kmani314/device-one/README.md

# 明方電気 device one

device one

The **device one** is a 60% mechanical keyboard kit that  contains two PCBs, mounting hardware, 3D-printed feet, and anti-skid  inserts. The PCB has a USB-C connector and supports ANSI, ISO,  split-backspace, split-shift, and arrow key layouts. It is programmable  using the open-source QMK software.
