kmani314/device-one/backplate/plot/backplate-Back.png

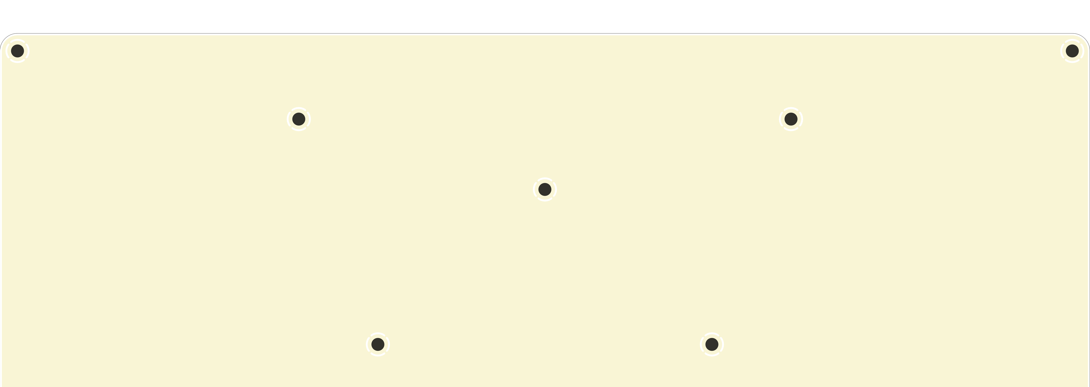
backplate/plot/backplate-Back.png
