kmani314/device-one/backplate/plot/backplate-Front.png

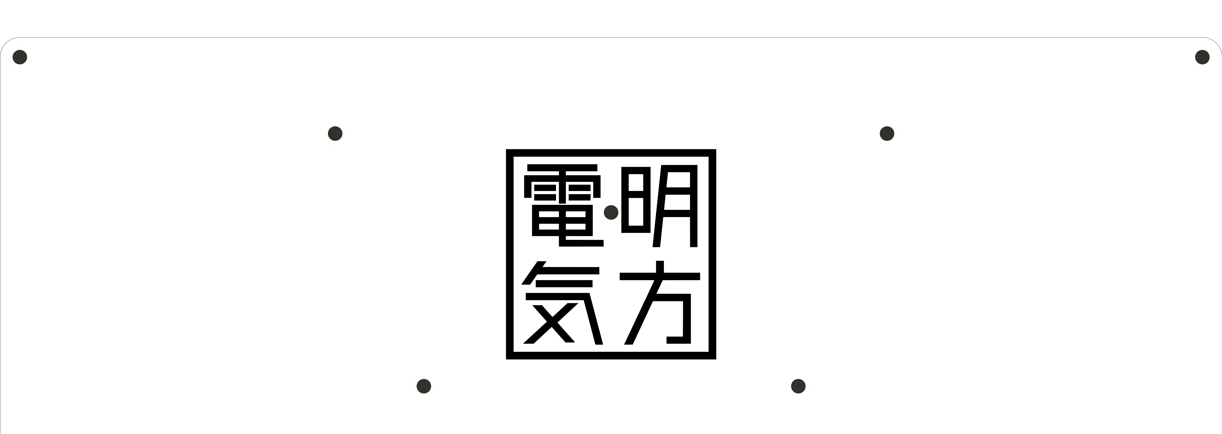
backplate/plot/backplate-Front.png
