kmani314/device-one/board/plot/61key-Back.png

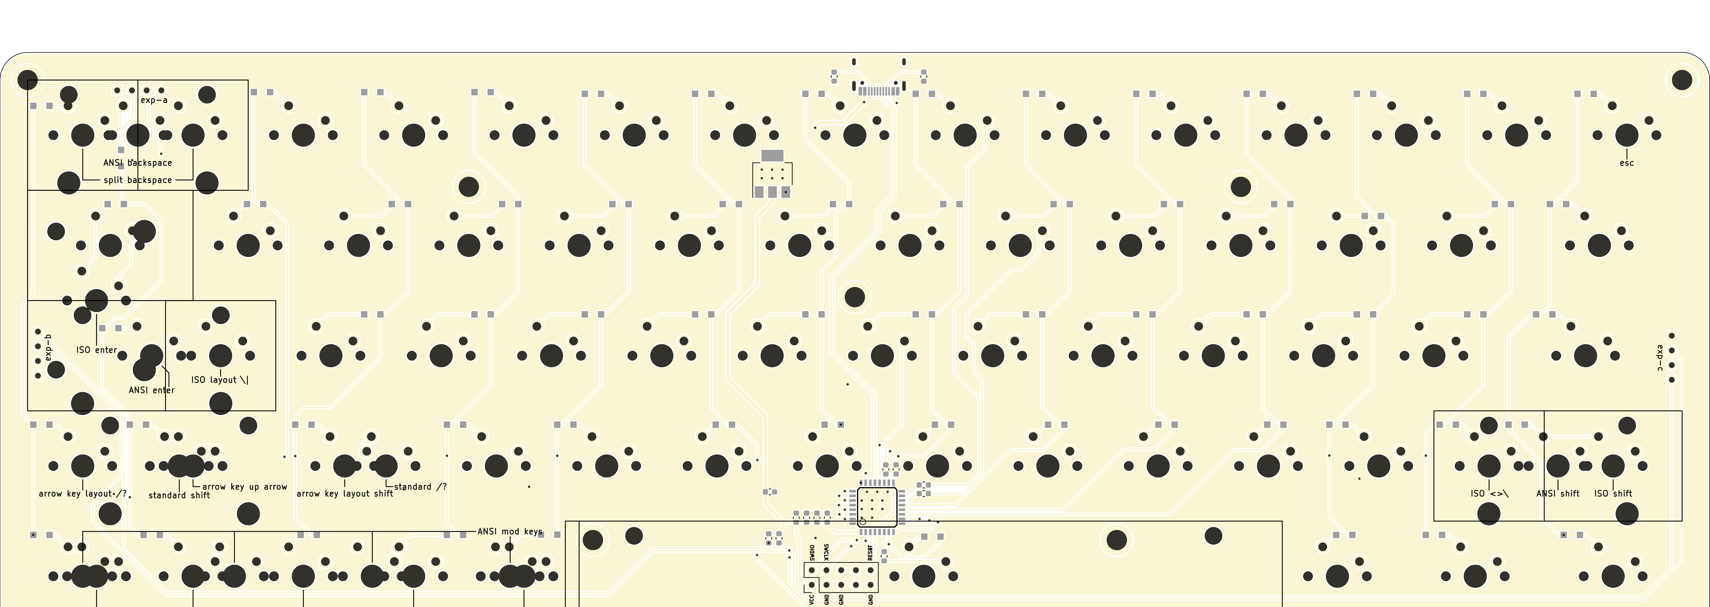
board/plot/61key-Back.png
