kmani314/device-one/board/plot/61key-Front.png

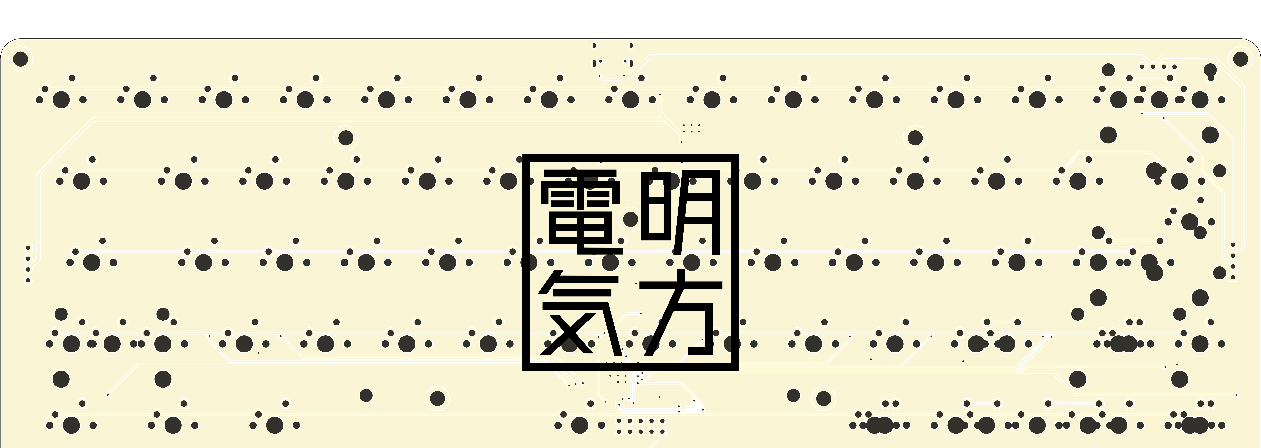
board/plot/61key-Front.png
