kmani314/device-one/backplate/backplate.step

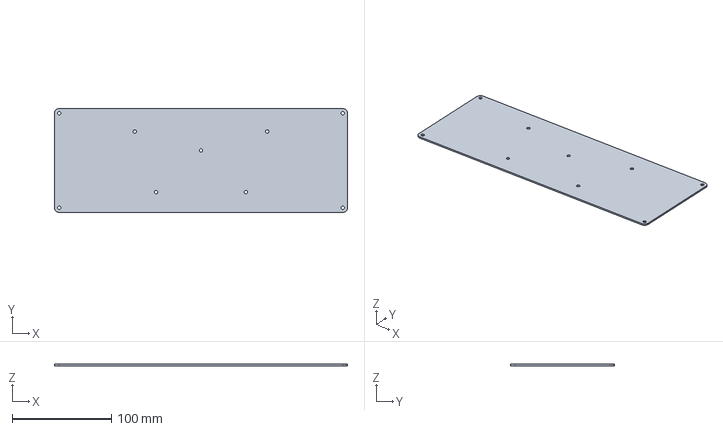
[picture p5: CAD file, 2020-05-29]
backplate/backplate.step
295.3 x 104.8 x 1.60 mm
