kmani314/device-one/board/61key.step

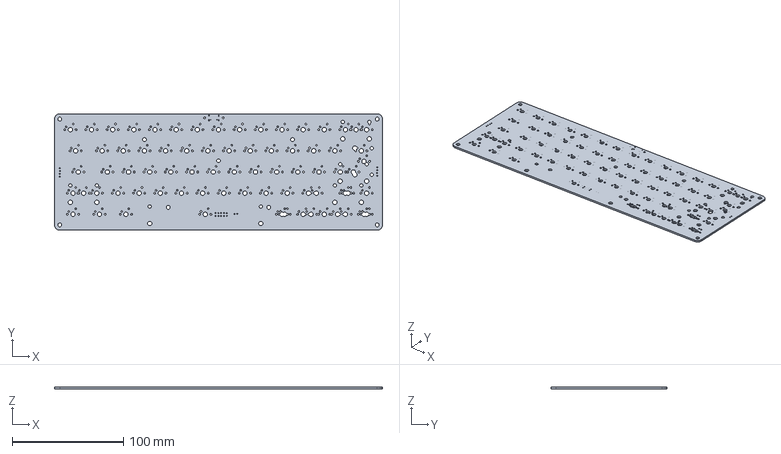
[picture p6: CAD file, 2020-06-21]
board/61key.step
295.3 x 104.8 x 1.60 mm
