kmani314/device-one/board/61key.kicad_pcb

## KiCad design board/61key.kicad_pcb (2020-07-10)

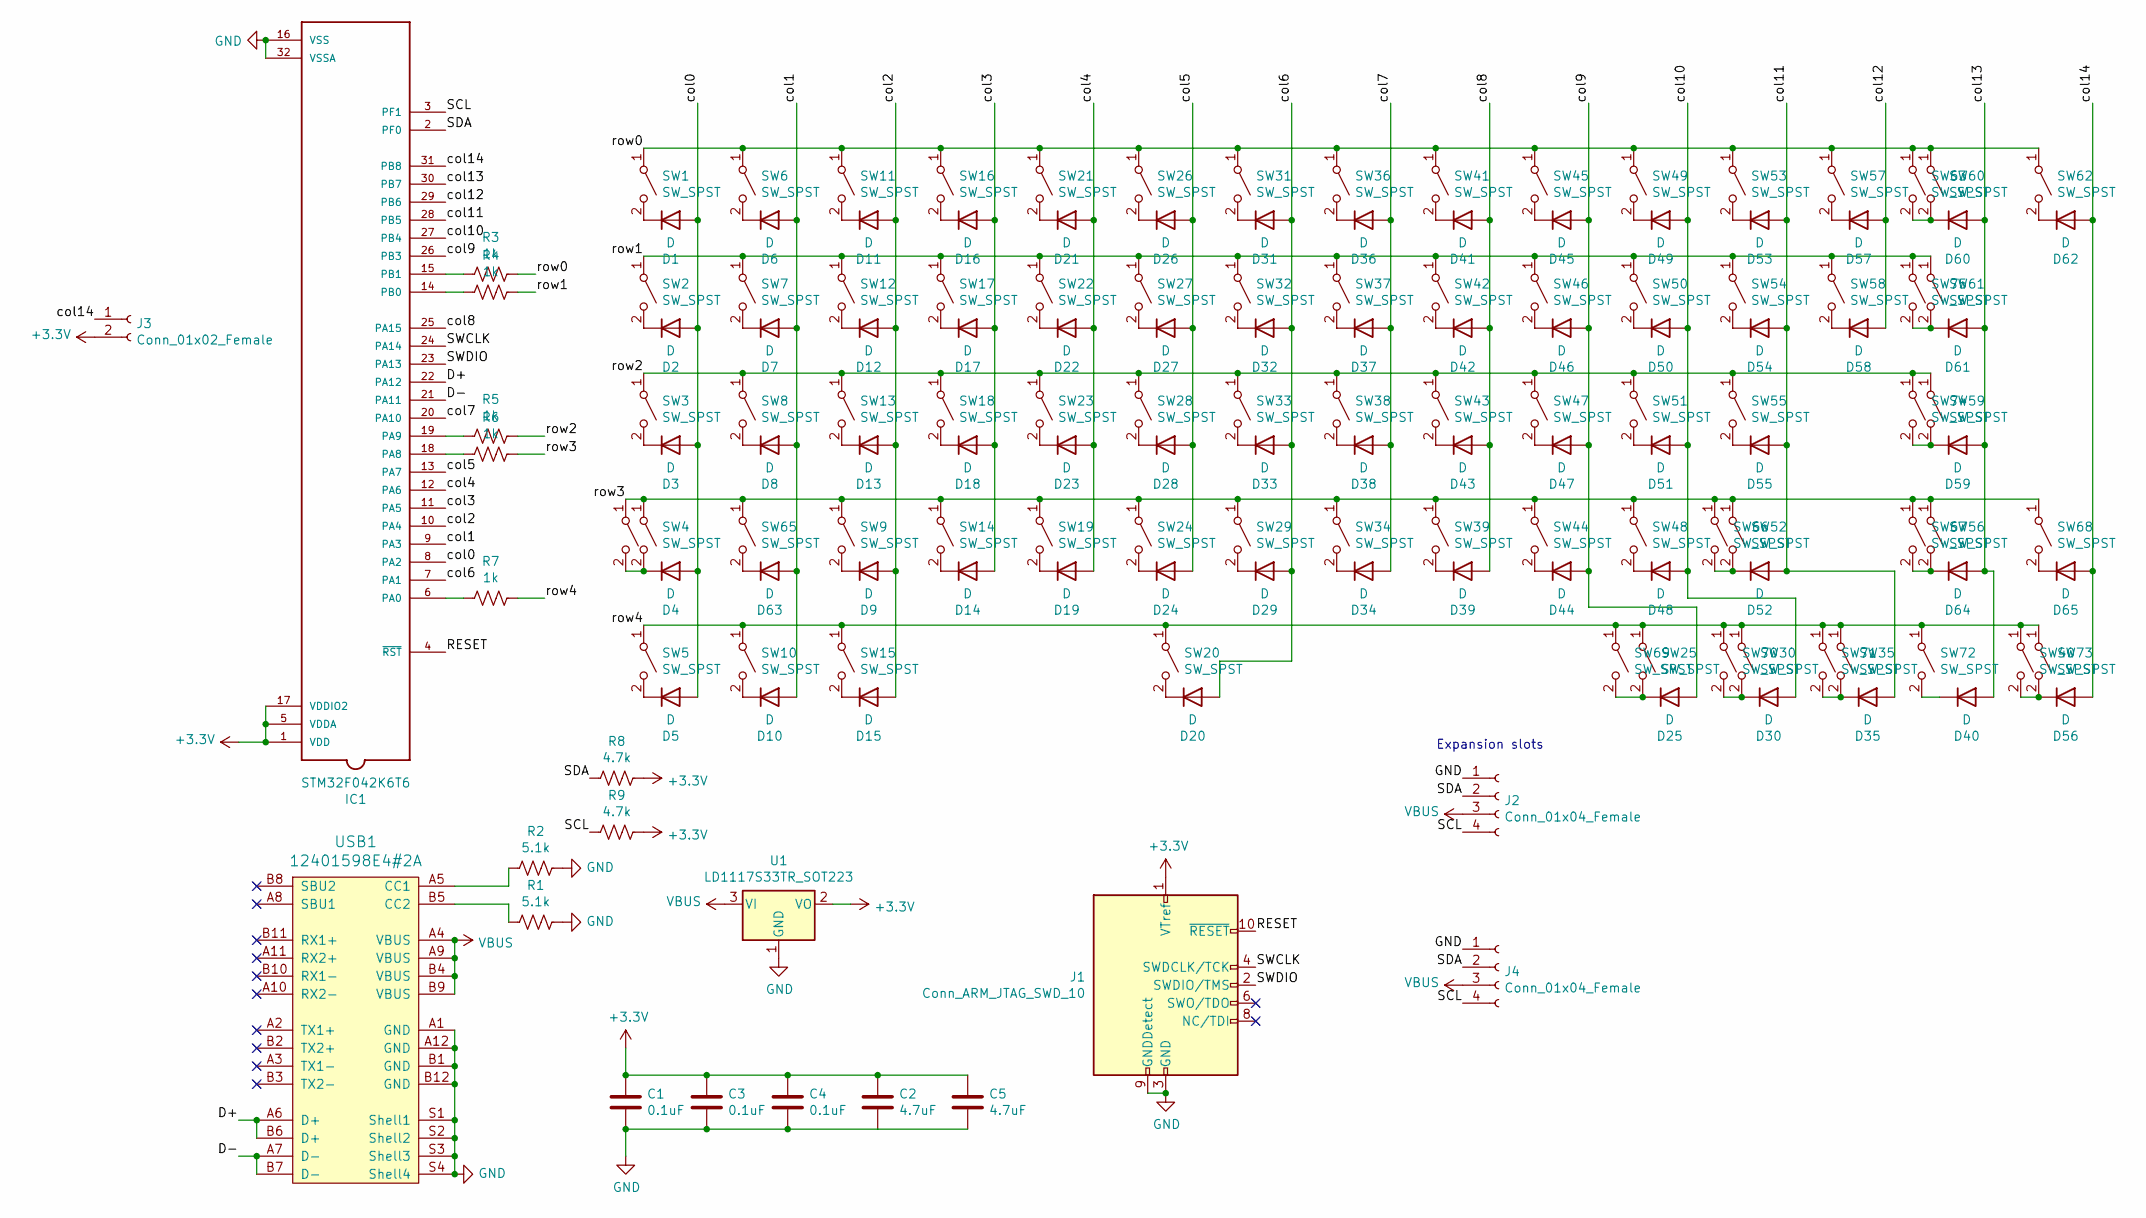
[picture p7: schematic 61key.sch]

Parts:
C1, C3, C4: 0.1uF; C_0603_1608Metric
C2, C5: 4.7uF; C_0603_1608Metric
D1, D2, D3, D4, D5, D6, D7, D8, D9, D10, D11, D12, D13, D14, D15, D16, D17, D18, D19, D20, D21, D22, D23, D24, D25, D26, D27, D28, D29, D30, D31, D32, D33, D34, D35, D36, D37, D38, D39, D40, D41, D42, D43, D44, D45, D46, D47, D48, D49, D50, D51, D52, D53, D54, D55, D56, D57, D58, D59, D60, D61, D62, D63, D64, D65: D; D_SOD-123F
IC1: STM32F042K6T6; QFP80P900X900X160-32N
J1: Conn_ARM_JTAG_SWD_10; PinHeader_2x05_P2.54mm_Vertical
J2, J4: Conn_01x04_Female; exp_header
J3: Conn_01x02_Female; PinHeader_1x02_P2.54mm_Vertical
R1, R2: 5.1k; R_0603_1608Metric
R3, R4, R5, R6, R7: 1k; R_0603_1608Metric
R8, R9: 4.7k; R_0603_1608Metric
SW1, SW2, SW3, SW4, SW5, SW6, SW7, SW8, SW9, SW10, SW11, SW12, SW13, SW14, SW15, SW16, SW17, SW18, SW19, SW20, SW21, SW22, SW23, SW24, SW25, SW26, SW27, SW28, SW29, SW30, SW31, SW32, SW33, SW34, SW35, SW36, SW37, SW38, SW39, SW40, SW41, SW42, SW43, SW44, SW45, SW46, SW47, SW48, SW49, SW50, SW51, SW52, SW53, SW54, SW55, SW56, SW57, SW58, SW59, SW60, SW61, SW62, SW63, SW64, SW65, SW66, SW67, SW68, SW69, SW70, SW71, SW72, SW73, SW74, SW75: SW_SPST; SW_MX
U1: LD1117S33TR_SOT223; SOT-223-3_TabPin2
USB1: 12401598E4#2A; HRO-TYPE-C-31-M-12

Connections:
+3V3: C1.1, C2.1, C3.1, C4.1, C5.1, IC1.1 (VDD), IC1.5 (VDDA), IC1.17 (VDDIO2), J1.1 (VTref), J3.2, R8.1, R9.1, U1.2 (VO)
/D+: IC1.22 (PA12), USB1.A6 (D+), USB1.B6 (D+)
/D-: IC1.21 (PA11), USB1.A7 (D-), USB1.B7 (D-)
/RESET: IC1.4 (~RST~), J1.10 (~RESET~)
/SCL: IC1.3 (PF1), J2.4, J4.4, R9.2
/SDA: IC1.2 (PF0), J2.2, J4.2, R8.2
/SWCLK: IC1.24 (PA14), J1.4 (SWDCLK/TCK)
/SWDIO: IC1.23 (PA13), J1.2 (SWDIO/TMS)
/col0: D1.2 (A), D2.2 (A), D3.2 (A), D4.2 (A), D5.2 (A), IC1.8 (PA2)
/col1: D6.2 (A), D7.2 (A), D8.2 (A), D10.2 (A), D63.2 (A), IC1.9 (PA3)
/col2: D9.2 (A), D11.2 (A), D12.2 (A), D13.2 (A), D15.2 (A), IC1.10 (PA4)
/col3: D14.2 (A), D16.2 (A), D17.2 (A), D18.2 (A), IC1.11 (PA5)
/col4: D19.2 (A), D21.2 (A), D22.2 (A), D23.2 (A), IC1.12 (PA6)
/col5: D24.2 (A), D26.2 (A), D27.2 (A), D28.2 (A), IC1.13 (PA7)
/col6: D20.2 (A), D29.2 (A), D31.2 (A), D32.2 (A), D33.2 (A), IC1.7 (PA1)
/col7: D34.2 (A), D36.2 (A), D37.2 (A), D38.2 (A), IC1.20 (PA10)
/col8: D39.2 (A), D41.2 (A), D42.2 (A), D43.2 (A), IC1.25 (PA15)
/col9: D25.2 (A), D44.2 (A), D45.2 (A), D46.2 (A), D47.2 (A), IC1.26 (PB3)
/col10: D30.2 (A), D48.2 (A), D49.2 (A), D50.2 (A), D51.2 (A), IC1.27 (PB4)
/col11: D35.2 (A), D52.2 (A), D53.2 (A), D54.2 (A), D55.2 (A), IC1.28 (PB5)
/col12: D57.2 (A), D58.2 (A), IC1.29 (PB6)
/col13: D40.2 (A), D59.2 (A), D60.2 (A), D61.2 (A), D64.2 (A), IC1.30 (PB7)
/col14: D56.2 (A), D62.2 (A), D65.2 (A), IC1.31 (PB8), J3.1
/row0: R3.1, SW1.1 (A), SW6.1 (A), SW11.1 (A), SW16.1 (A), SW21.1 (A), SW26.1 (A), SW31.1 (A), SW36.1 (A), SW41.1 (A), SW45.1 (A), SW49.1 (A), SW53.1 (A), SW57.1 (A), SW60.1 (A), SW62.1 (A), SW63.1 (A)
/row1: R4.1, SW2.1 (A), SW7.1 (A), SW12.1 (A), SW17.1 (A), SW22.1 (A), SW27.1 (A), SW32.1 (A), SW37.1 (A), SW42.1 (A), SW46.1 (A), SW50.1 (A), SW54.1 (A), SW58.1 (A), SW61.1 (A), SW75.1 (A)
/row2: R5.1, SW3.1 (A), SW8.1 (A), SW13.1 (A), SW18.1 (A), SW23.1 (A), SW28.1 (A), SW33.1 (A), SW38.1 (A), SW43.1 (A), SW47.1 (A), SW51.1 (A), SW55.1 (A), SW59.1 (A), SW74.1 (A)
/row3: R6.1, SW4.1 (A), SW9.1 (A), SW14.1 (A), SW19.1 (A), SW24.1 (A), SW29.1 (A), SW34.1 (A), SW39.1 (A), SW44.1 (A), SW48.1 (A), SW52.1 (A), SW56.1 (A), SW64.1 (A), SW65.1 (A), SW66.1 (A), SW67.1 (A), SW68.1 (A)
/row4: R7.1, SW5.1 (A), SW10.1 (A), SW15.1 (A), SW20.1 (A), SW25.1 (A), SW30.1 (A), SW35.1 (A), SW40.1 (A), SW69.1 (A), SW70.1 (A), SW71.1 (A), SW72.1 (A), SW73.1 (A)
GND: C1.2, C2.2, C3.2, C4.2, C5.2, IC1.16 (VSS), IC1.32 (VSSA), J1.3 (GND), J1.5 (GND), J1.9 (GNDDetect), J2.1, J4.1, R1.1, R2.1, U1.1 (GND), USB1.A1 (GND), USB1.A12 (GND), USB1.B1 (GND), USB1.B12 (GND), USB1.S1 (Shell1), USB1.S2 (Shell2), USB1.S3 (Shell3), USB1.S4 (Shell4)
unnamed: D1.1 (K), SW1.2 (B)
unnamed: D2.1 (K), SW2.2 (B)
unnamed: D3.1 (K), SW3.2 (B)
unnamed: D4.1 (K), SW4.2 (B), SW64.2 (B)
unnamed: D5.1 (K), SW5.2 (B)
unnamed: D6.1 (K), SW6.2 (B)
unnamed: D7.1 (K), SW7.2 (B)
unnamed: D8.1 (K), SW8.2 (B)
unnamed: D9.1 (K), SW9.2 (B)
unnamed: D10.1 (K), SW10.2 (B)
unnamed: D11.1 (K), SW11.2 (B)
unnamed: D12.1 (K), SW12.2 (B)
unnamed: D13.1 (K), SW13.2 (B)
unnamed: D14.1 (K), SW14.2 (B)
unnamed: D15.1 (K), SW15.2 (B)
unnamed: D16.1 (K), SW16.2 (B)
unnamed: D17.1 (K), SW17.2 (B)
unnamed: D18.1 (K), SW18.2 (B)
unnamed: D19.1 (K), SW19.2 (B)
unnamed: D20.1 (K), SW20.2 (B)
unnamed: D21.1 (K), SW21.2 (B)
unnamed: D22.1 (K), SW22.2 (B)
unnamed: D23.1 (K), SW23.2 (B)
unnamed: D24.1 (K), SW24.2 (B)
unnamed: D25.1 (K), SW25.2 (B), SW69.2 (B)
unnamed: D26.1 (K), SW26.2 (B)
unnamed: D27.1 (K), SW27.2 (B)
unnamed: D28.1 (K), SW28.2 (B)
unnamed: D29.1 (K), SW29.2 (B)
unnamed: D30.1 (K), SW30.2 (B), SW70.2 (B)
unnamed: D31.1 (K), SW31.2 (B)
unnamed: D32.1 (K), SW32.2 (B)
unnamed: D33.1 (K), SW33.2 (B)
unnamed: D34.1 (K), SW34.2 (B)
unnamed: D35.1 (K), SW35.2 (B), SW71.2 (B)
unnamed: D36.1 (K), SW36.2 (B)
unnamed: D37.1 (K), SW37.2 (B)
unnamed: D38.1 (K), SW38.2 (B)
unnamed: D39.1 (K), SW39.2 (B)
unnamed: D40.1 (K), SW72.2 (B)
unnamed: D41.1 (K), SW41.2 (B)
unnamed: D42.1 (K), SW42.2 (B)
unnamed: D43.1 (K), SW43.2 (B)
unnamed: D44.1 (K), SW44.2 (B)
unnamed: D45.1 (K), SW45.2 (B)
unnamed: D46.1 (K), SW46.2 (B)
unnamed: D47.1 (K), SW47.2 (B)
unnamed: D48.1 (K), SW48.2 (B)
unnamed: D49.1 (K), SW49.2 (B)
unnamed: D50.1 (K), SW50.2 (B)
unnamed: D51.1 (K), SW51.2 (B)
unnamed: D52.1 (K), SW52.2 (B), SW66.2 (B)
unnamed: D53.1 (K), SW53.2 (B)
unnamed: D54.1 (K), SW54.2 (B)
unnamed: D55.1 (K), SW55.2 (B)
unnamed: D56.1 (K), SW40.2 (B), SW73.2 (B)
unnamed: D57.1 (K), SW57.2 (B)
unnamed: D58.1 (K), SW58.2 (B)
unnamed: D59.1 (K), SW59.2 (B), SW74.2 (B)
unnamed: D60.1 (K), SW60.2 (B), SW63.2 (B)
unnamed: D61.1 (K), SW61.2 (B), SW75.2 (B)
unnamed: D62.1 (K), SW62.2 (B)
unnamed: D63.1 (K), SW65.2 (B)
unnamed: D64.1 (K), SW56.2 (B), SW67.2 (B)
unnamed: D65.1 (K), SW68.2 (B)
unnamed: IC1.6 (PA0), R7.2
unnamed: IC1.14 (PB0), R4.2
unnamed: IC1.15 (PB1), R3.2
unnamed: IC1.18 (PA8), R6.2
unnamed: IC1.19 (PA9), R5.2
unnamed: R1.2, USB1.B5 (CC2)
unnamed: R2.2, USB1.A5 (CC1)
VBUS: J2.3, J4.3, U1.3 (VI), USB1.A4 (VBUS), USB1.A9 (VBUS), USB1.B4 (VBUS), USB1.B9 (VBUS)

Notes on the sheet:
Expansion slots

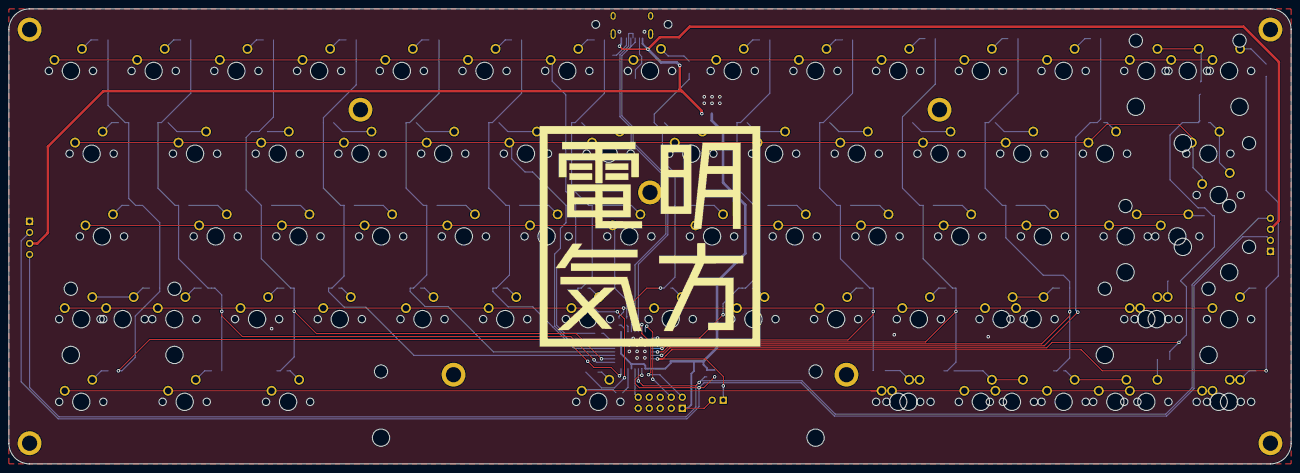
[picture p8: board 61key.kicad_pcb from above]

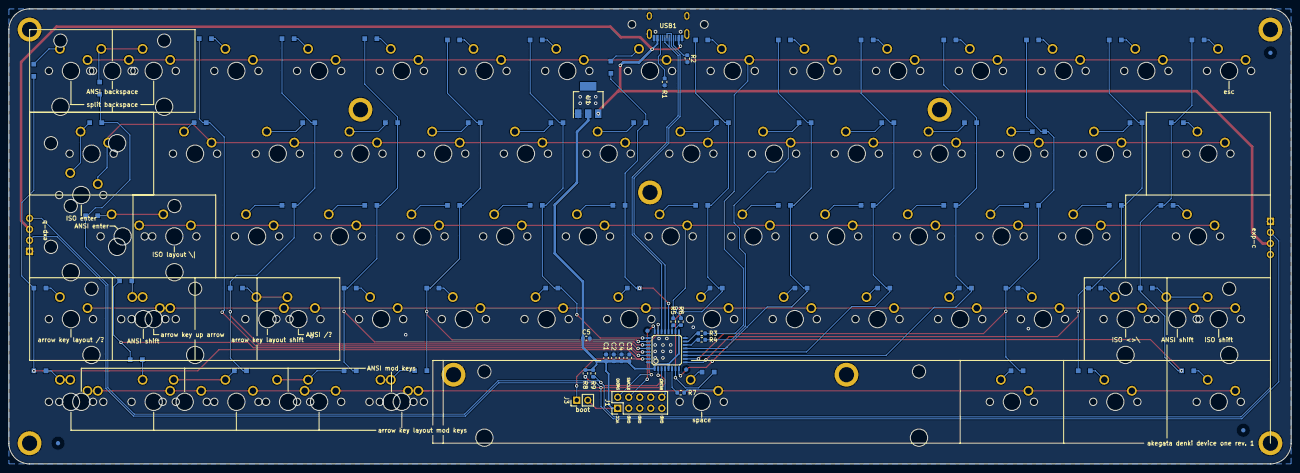
[picture p9: board 61key.kicad_pcb from below]

Board: 2 copper layers, 295.3 x 104.8 mm, 172 parts (89 on the bottom side), 102 nets.

Other parts of the board:
>NAME: >VALUE; MX_STAB_6.75U
>NAME#2: >VALUE; MX_STAB_2.75U
>NAME#3, >NAME#4: >VALUE; MX_STAB_2.25U
F1, F4, F5: Fiducial_1mm_Mask3mm
F2, F3: Fiducial_1mm_Mask2mm
ST72, ST72#2: Stabilizer; MX_STAB_2U
