kmani314/device-one/(commit log)

2020-05-03 add footprints, finish basic schematic, working on pcb
    [61key.kicad_pcb, 61key.sch, Keyboard.sch]
2020-05-04 footprints, key arrangement, board dimensions
    [61key.kicad_pcb, 61key.sch]
2020-05-05 basic pcb, issues with holes
    [61key.kicad_pcb, 61key.sch]
2020-05-06 add step for renders
    [61key.step]
2020-05-06 optimize entire board
    [61key.kicad_pcb, 61key.sch]
2020-05-07 clean up files, move things to their own directories
    [61key.kicad_pcb, 61key.sch, 61key.step, Keyboard.sch]
2020-05-07 add pads, new step
    [61key.kicad_pcb, 61key.sch, 61key.step]
2020-05-07 add board images, remove svg
    [61key.sch]
2020-05-07 add better img and logo
    [61key.kicad_pcb]
2020-05-09 new images, backplate, clean up for smt assembly
    [61key.kicad_pcb, 61key.sch, backplate.kicad_pcb, backplate.sch]
2020-05-13 big overhaul
    [61key.kicad_pcb, 61key.sch, 61key.step]
2020-05-14 layouts done, need to add traces
    [61key.kicad_pcb, 61key.sch, 61key.step]
2020-05-15 rows and columns for all layouts done
    [61key.kicad_pcb, 61key.sch]
2020-05-16 basic pcb done
    [61key.kicad_pcb, 61key.sch]
2020-05-17 need to create models to check board compatibility; prototype candidate
    [61key.kicad_pcb, 61key.sch, 61key.step, backplate.kicad_pcb, backplate.sch, backplate.step]
2020-05-17 logos, gerber
    [61key.kicad_pcb, 61key.step, backplate.kicad_pcb, backplate.step]
2020-05-17 backplate fixes
    [61key.kicad_pcb, backplate.kicad_pcb]
2020-05-26 add dxf
    [61key-B_Fab.dxf, 61key-B_Mask.dxf, 61key-B_SilkS.dxf, 61key-Edge_Cuts.dxf, 61key-F_Cu.dxf, 61key-F_Fab.dxf, 61key-F_Mask.dxf, 61key-F_SilkS.dxf]
2020-05-29 new images and steps
    [61key.step, backplate.step]
2020-06-21 update step file
    [61key.step]
2020-07-10 add readme
    [61key.kicad_pcb]
